TENSRO/Siload/hardware/silo_unit/README.md

# SILOAD LOAD CELL REV A — Silo Unit Carrier PCB (`68 × 44 mm`)

Silo Unit 3D Hero

Silo Unit Top View

Both Siload PCBs — Farm Hub & Silo Unit

Routing Plot

Zie [`ONTWERP.md`](ONTWERP.md) en [`../PINOUT.md`](../PINOUT.md) voor het volledige aansluitschema, de waarheidstabel van de `CD4052BE` multiplexer (`U1`) en de BOM (`BOM.csv`).

## Productie-Gerbers (JLCPCB / PCBWay / Eurocircuits)
- **Kant-en-klare ZIP voor upload:** [`SILOAD-SILO-UNIT-REV-A-gerbers.zip`](SILOAD-SILO-UNIT-REV-A-gerbers.zip)
- **Losse Gerber- en Excellon-boorbestanden:** [`gerbers/`](gerbers/) (`F.Cu`, `B.Cu`, `F.Mask`, `B.Mask`, `F.SilkS`, `B.SilkS`, `F.Paste`, `B.Paste`, `Edge.Cuts`, `PTH.drl`, `NPTH.drl`)
