TENSRO/Siload/hardware/farm_hub/README.md

# SILOAD REV A — Farm Hub Carrier PCB (`59 × 36 mm`)

Farm Hub 3D Hero

Farm Hub Top View

Both Siload PCBs — Farm Hub & Silo Unit

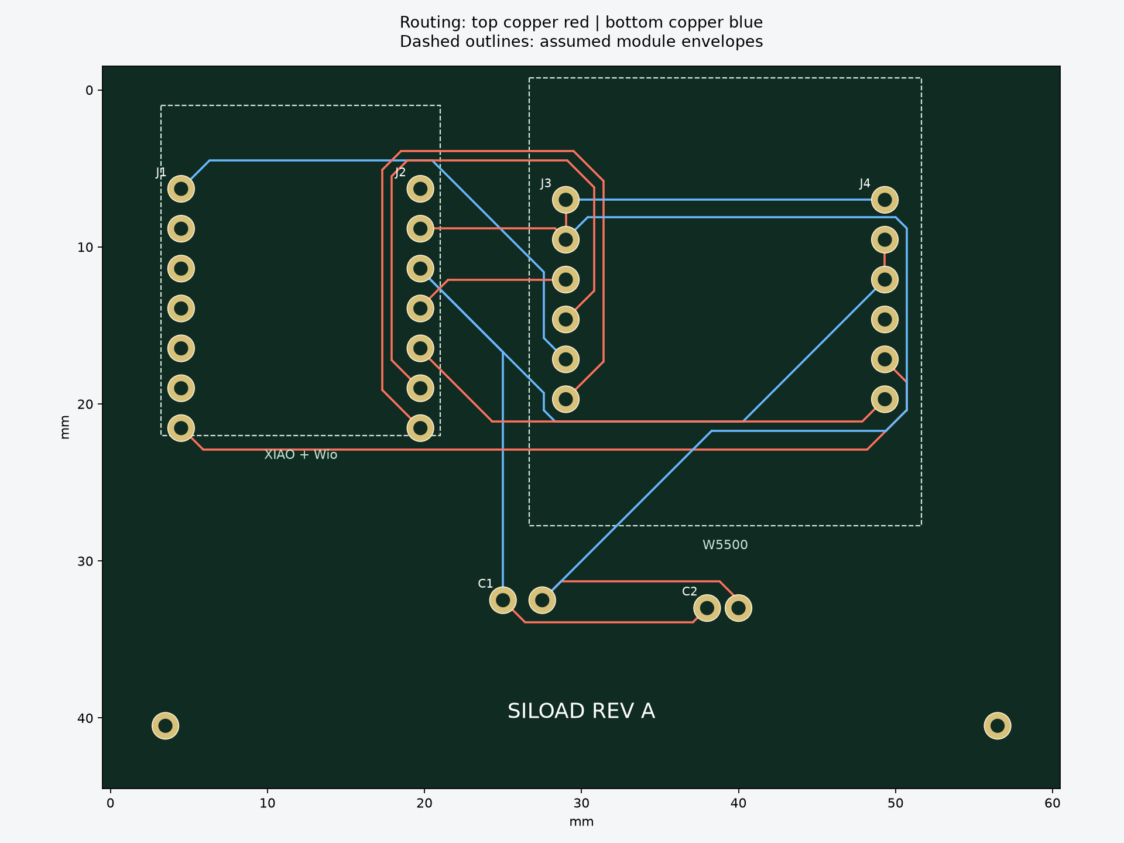
[picture p7: hardware/farm_hub/SILOAD REV A-routing.png]
Routing Plot


Zie [`ONTWERP.md`](ONTWERP.md) en [`../PINOUT.md`](../PINOUT.md) voor het volledige aansluitschema en de BOM (`BOM.csv`).
