TENSRO/Siload/hardware/farm_hub/SILOAD REV A-compact-render.png

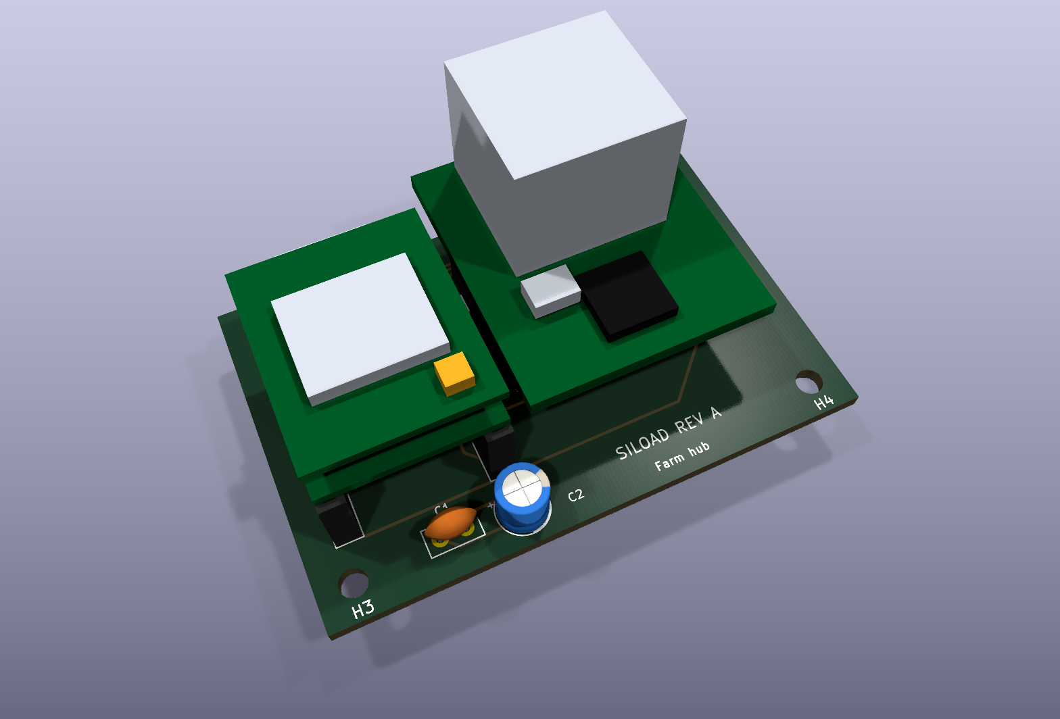
hardware/farm_hub/SILOAD REV A-compact-render.png
