TENSRO/Siload/hardware/farm_hub/SILOAD REV A-compact-top.png

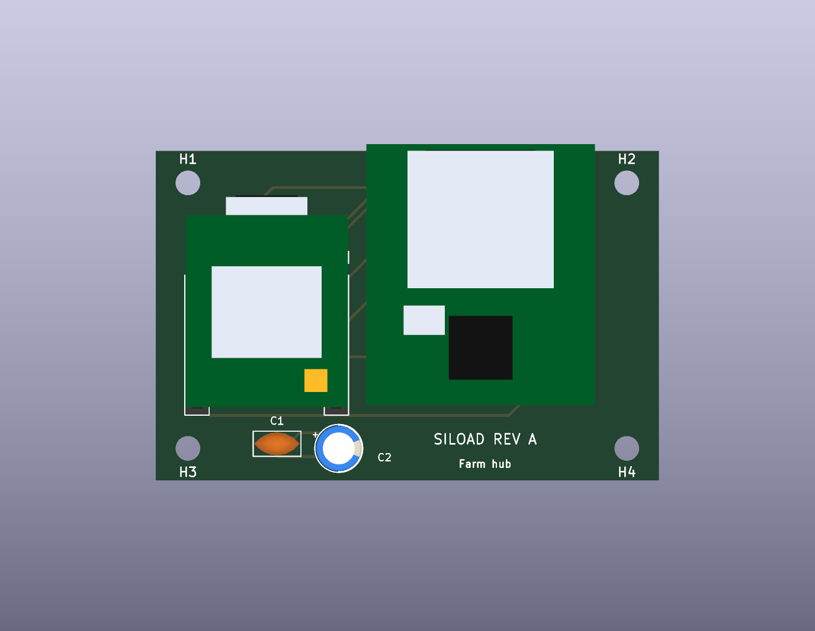
hardware/farm_hub/SILOAD REV A-compact-top.png
