TENSRO/Siload/hardware/farm_hub/visuals/SILOAD REV A-01-hero.png

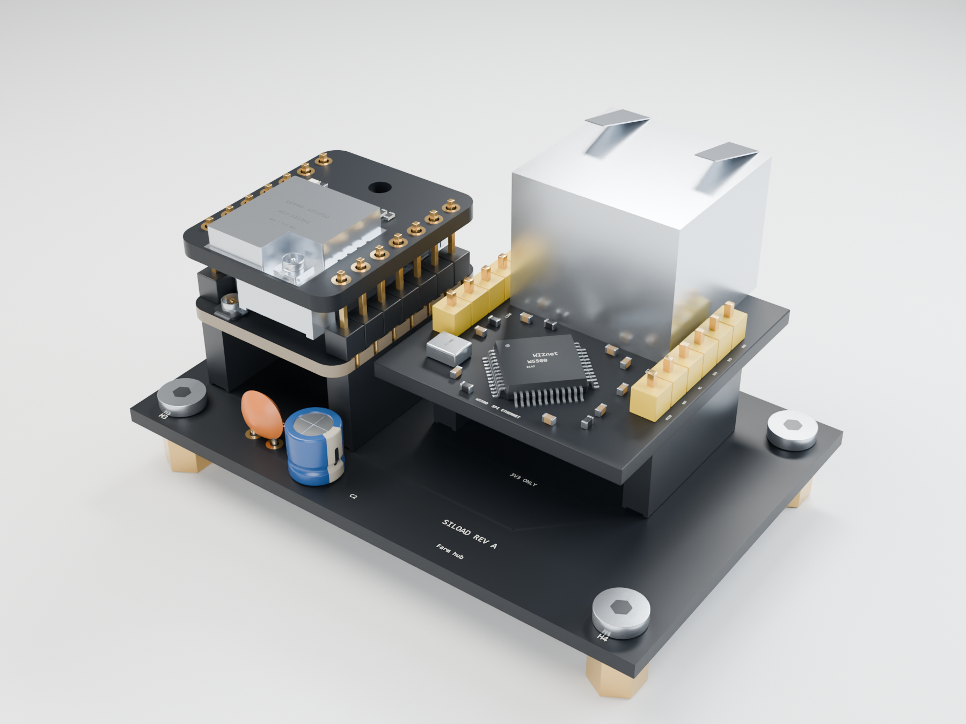
hardware/farm_hub/visuals/SILOAD REV A-01-hero.png
