TENSRO/Siload/hardware/farm_hub/visuals/SILOAD REV A-02-connectors.png

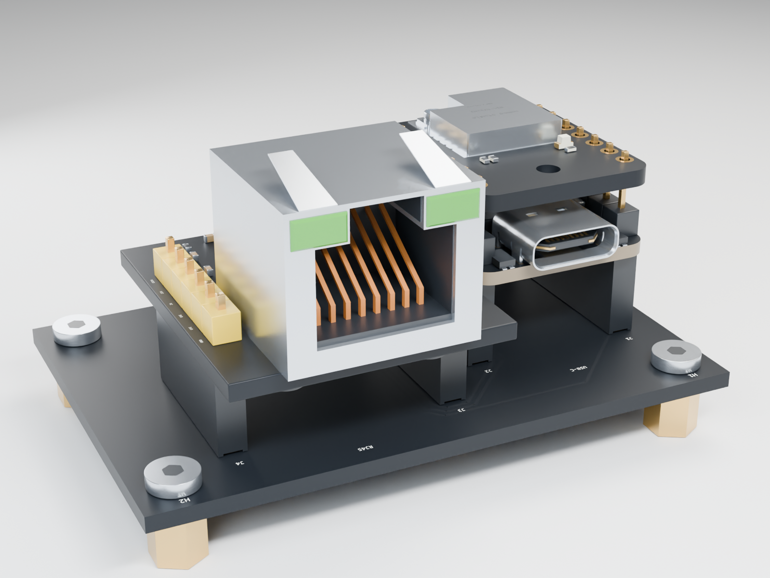
hardware/farm_hub/visuals/SILOAD REV A-02-connectors.png
