TENSRO/Siload/hardware/farm_hub/visuals/SILOAD REV A-03-detail.png

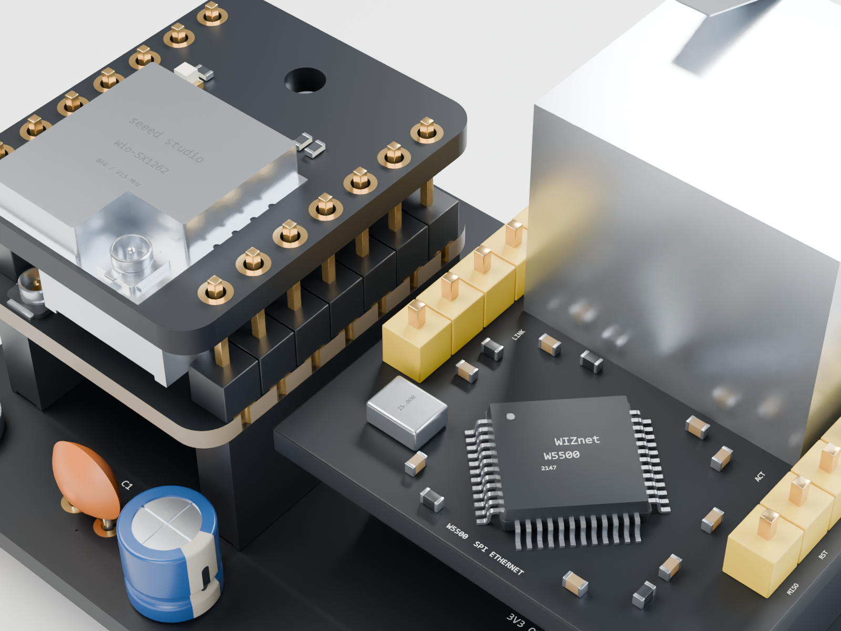
hardware/farm_hub/visuals/SILOAD REV A-03-detail.png
