TENSRO/Siload/hardware/silo_unit/branding/SiLoad-original.png

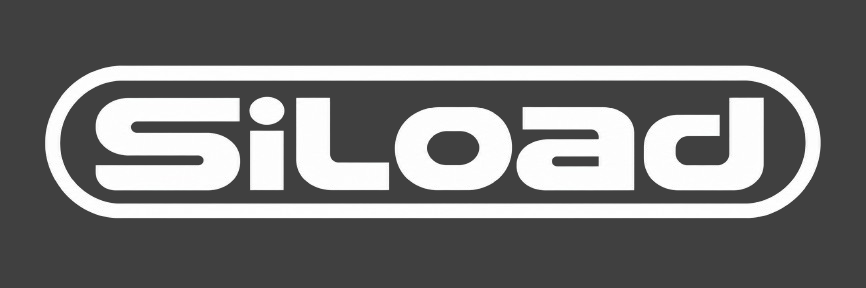
hardware/silo_unit/branding/SiLoad-original.png
