TENSRO/Siload/hardware/silo_unit/SILOAD LOAD CELL REV A-top.png

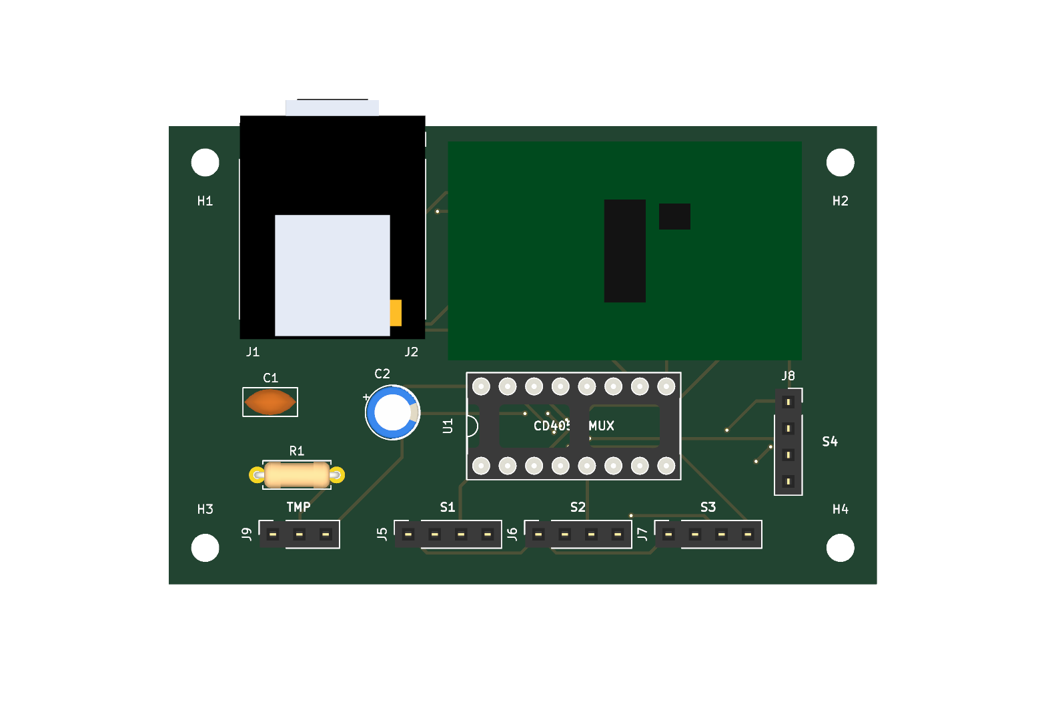
hardware/silo_unit/SILOAD LOAD CELL REV A-top.png
