TENSRO/Siload/hardware/silo_unit/visuals/SILOAD LOAD CELL REV A-03-detail.png

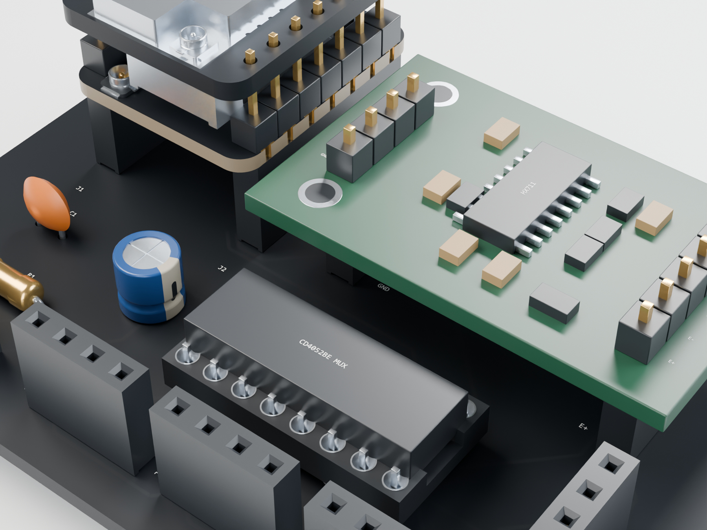
hardware/silo_unit/visuals/SILOAD LOAD CELL REV A-03-detail.png
