TENSRO/Siload/hardware/silo_unit/BOM.csv

Reference | Quantity | Description | Footprint
J1,J2 | 2 | Female header 1x7 2.54mm for XIAO ESP32-S3 + Wio-SX1262 stack | PinSocket_1x07_P2.54mm_Vertical
J3 | 1 | Female header 1x4 2.54mm for Heemol HX711 MCU side (VCC, SCK, DT, GND) | PinSocket_1x04_P2.54mm_Vertical
J4 | 1 | Female header 1x6 2.54mm for Heemol HX711 Bridge side (B+, B-, A+, A-, E-, E+) | PinSocket_1x06_P2.54mm_Vertical
U1 | 1 | CD4052BE or 74HC4052N dual 4-channel analog multiplexer (DIP-16) + 16-pin DIP socket | DIP-16_W7.62mm_Socket
J5..J8 | 4 | 4-pin 2.54mm header/socket for 4 load-cell sensors (E+, E-, A-, A+) | PinSocket_1x04_P2.54mm_Vertical
J9 | 1 | 3-pin 2.54mm header/socket for DS18B20 temperature sensor (3V3, DQ, GND) | PinSocket_1x03_P2.54mm_Vertical
J10 | 1 | 2-pin 2.54mm power header/socket (+5V, GND) for external 5V supply | PinSocket_1x02_P2.54mm_Vertical
R1 | 1 | 4.7k Ohm axial through-hole resistor (1-Wire pull-up to 3V3) | R_Axial_DIN0207_L6.3mm_D2.5mm_P7.62mm_Horizontal
C1 | 1 | 100nF 50V ceramic through-hole decoupling capacitor | C_Disc_D5.0mm_W2.5mm_P2.50mm
C2 | 1 | 10uF 16V radial electrolytic bulk decoupling capacitor on 3V3 | CP_Radial_D5.0mm_P2.00mm
H1..H4 | 4 | M2.5 mounting holes (2.7mm drill, screw head <=5mm) | MountingHole_2.7mm_M2.5
