TENSRO/Siload/hardware/farm_hub/SILOAD REV A-assembly.step

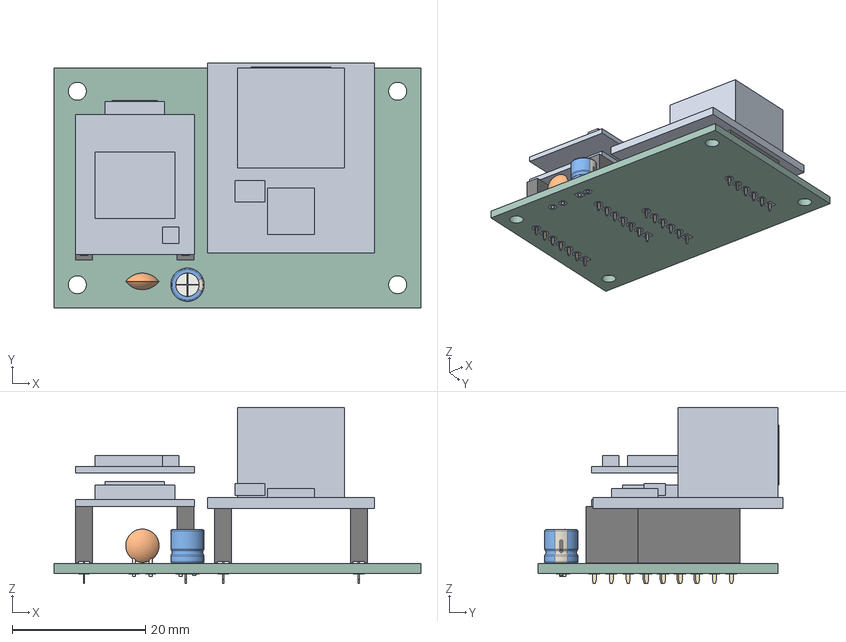
[picture p16: CAD file, 2026-10-27]
hardware/farm_hub/SILOAD REV A-assembly.step
55.0 x 36.8 x 26.4 mm
C_Disc_D50mm_W25mm_P250mm
PinSocket_1x07_P2.54mm_Vertical x 2
PinSocket_1x06_P2.54mm_Vertical x 2
CP_Radial_D50mm_P200mm
SILOAD REV A_pad
SILOAD REV A_PCB
