TENSRO/Siload/hardware/silo_unit/SILOAD LOAD CELL REV A-assembly.step

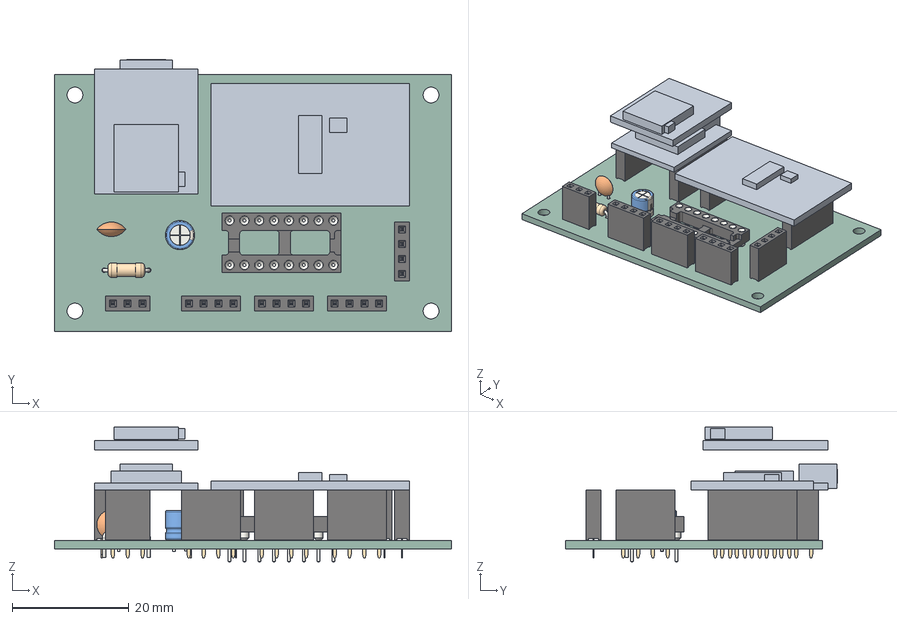
[picture p17: CAD file, 2026-10-27]
hardware/silo_unit/SILOAD LOAD CELL REV A-assembly.step
68.0 x 46.6 x 23.1 mm
CP_Radial_D50mm_P200mm
DIP_16_W762mm_Socket
PinSocket_1x03_P2.54mm_Vertical
PinSocket_1x04_P2.54mm_Vertical x 5
C_Disc_D50mm_W25mm_P250mm
PinSocket_1x07_P2.54mm_Vertical x 2
R_Axial_DIN0207_L63mm_D25mm_P762mm_Horizontal
PinSocket_1x06_P2.54mm_Vertical
SILOAD LOAD CELL REV A_PCB
