TENSRO/Siload/hardware/farm_hub/models/w5500-indicative.step

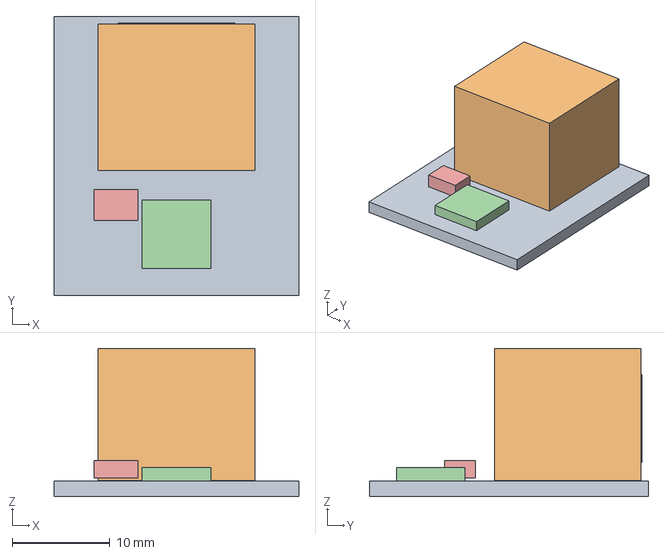
[picture p18: CAD file, 2026-10-27]
hardware/farm_hub/models/w5500-indicative.step
25.0 x 28.5 x 15.2 mm
