TENSRO/Siload/hardware/silo_unit/models/hx711-indicative.step

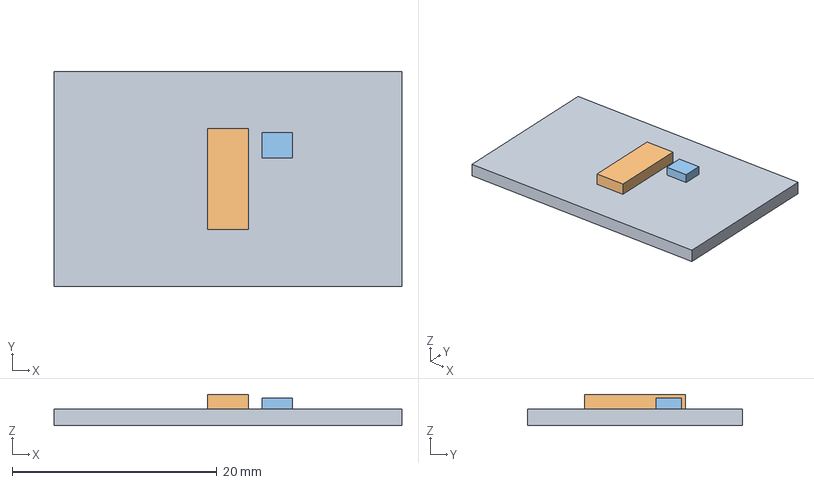
[picture p19: CAD file, 2026-10-27]
hardware/silo_unit/models/hx711-indicative.step
34.0 x 21.0 x 3.05 mm
