TENSRO/Siload/hardware/farm_hub/models/xiao-wio-indicative.step

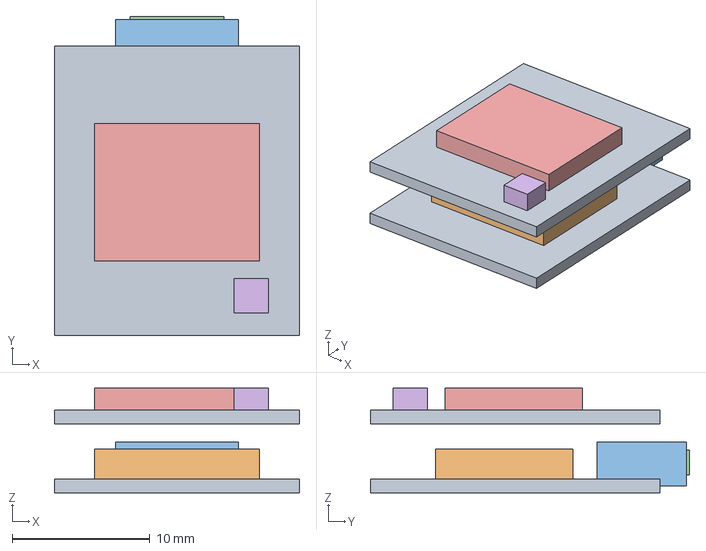
[picture p20: CAD file, 2026-10-27]
hardware/farm_hub/models/xiao-wio-indicative.step
17.8 x 23.1 x 7.60 mm
