TENSRO/Siload/hardware/farm_hub/SILOAD REV A-carrier.step

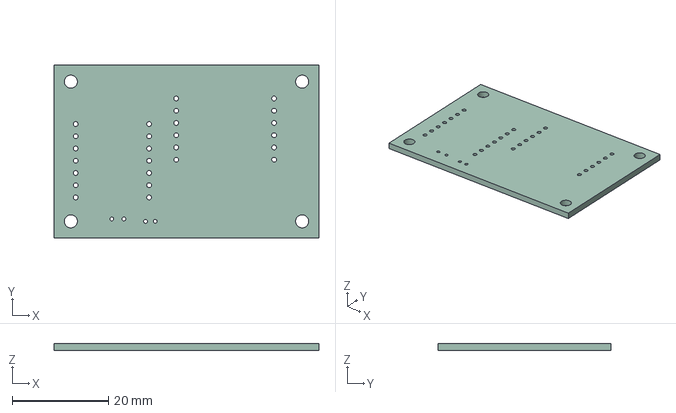
[picture p21: CAD file, 2026-10-27]
hardware/farm_hub/SILOAD REV A-carrier.step
55.0 x 36.0 x 1.51 mm
