TENSRO/Siload/(list of files, cad)

Other CAD files:
hardware/silo_unit/visuals/SILOAD LOAD CELL REV A-studio-branded.blend
