TENSRO/Siload/hardware/farm_hub/SILOAD REV A-schema.pdf

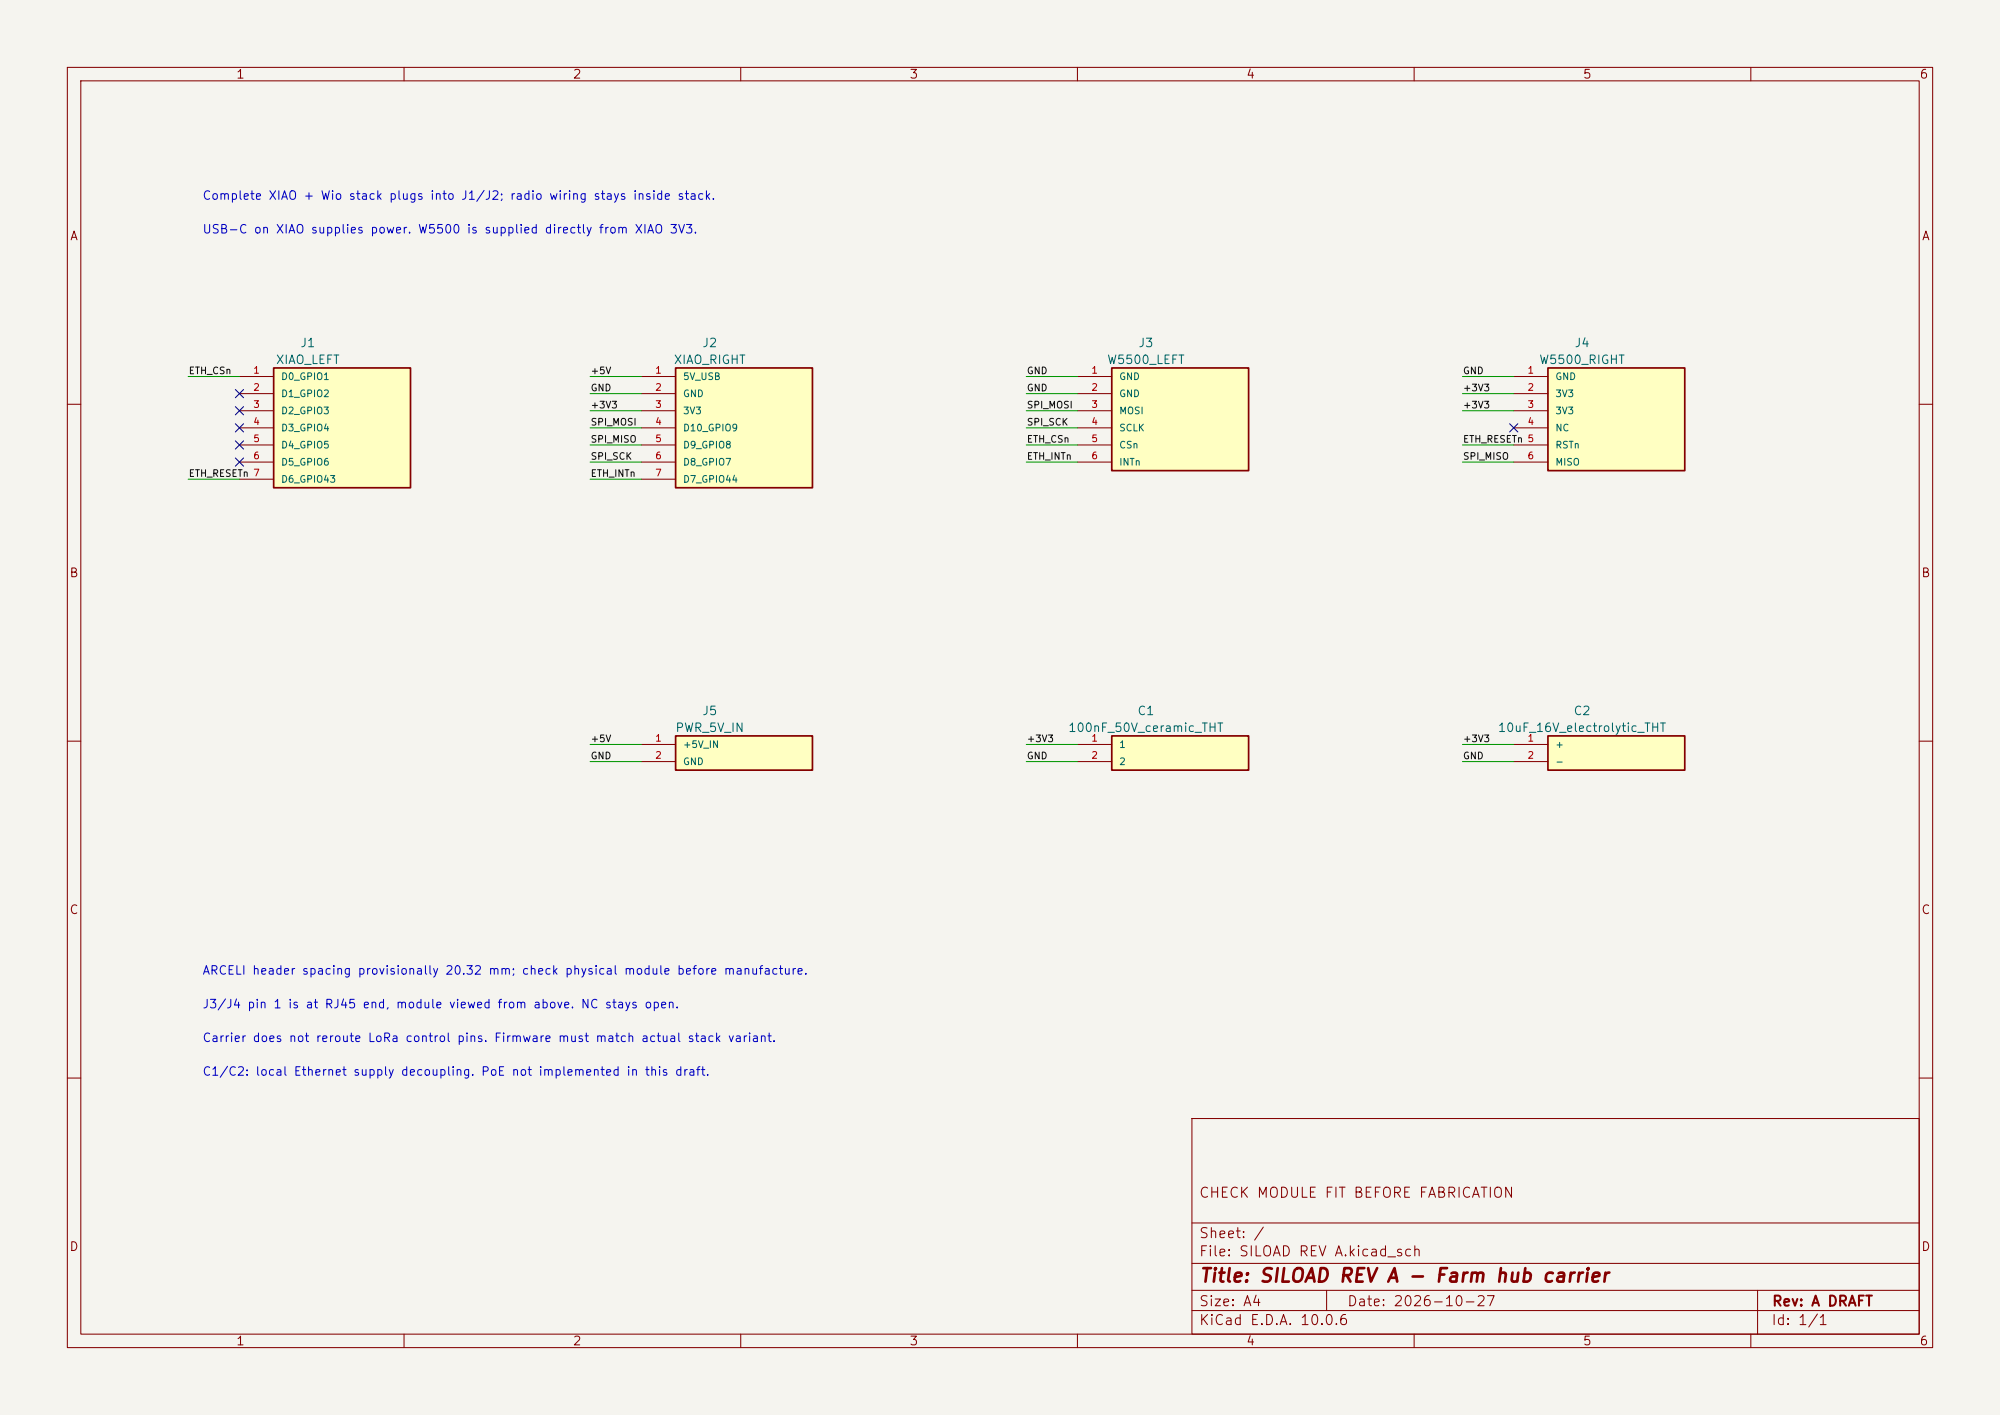
[picture p22: page 1]

USB-C on XIAO supplies power. W5500 is supplied directly from XIAO 3V3. Complete XIAO + Wio stack plugs into J1/J2; radio wiring stays inside stack. C1/C2: local Ethernet supply decoupling. PoE not implemented in this draft. J3/J4 pin 1 is at RJ45 end, module viewed from above. NC stays open. ARCELI header spacing provisionally 20.32 mm; check physical module before manufacture.

GND Carrier does not reroute LoRa control pins. Firmware must match actual stack variant.

CHECK MODULE FIT BEFORE FABRICATION

Sheet: /
File: SILOAD REV A.kicad_sch
Title: SILOAD REV A - Farm hub carrier

Size: A4 | Rev: A DRAFT
KiCad E.D.A. 10.0.6 | Id: 1/1
