TENSRO/Siload/hardware/silo_unit/SILOAD LOAD CELL REV A-schema.pdf

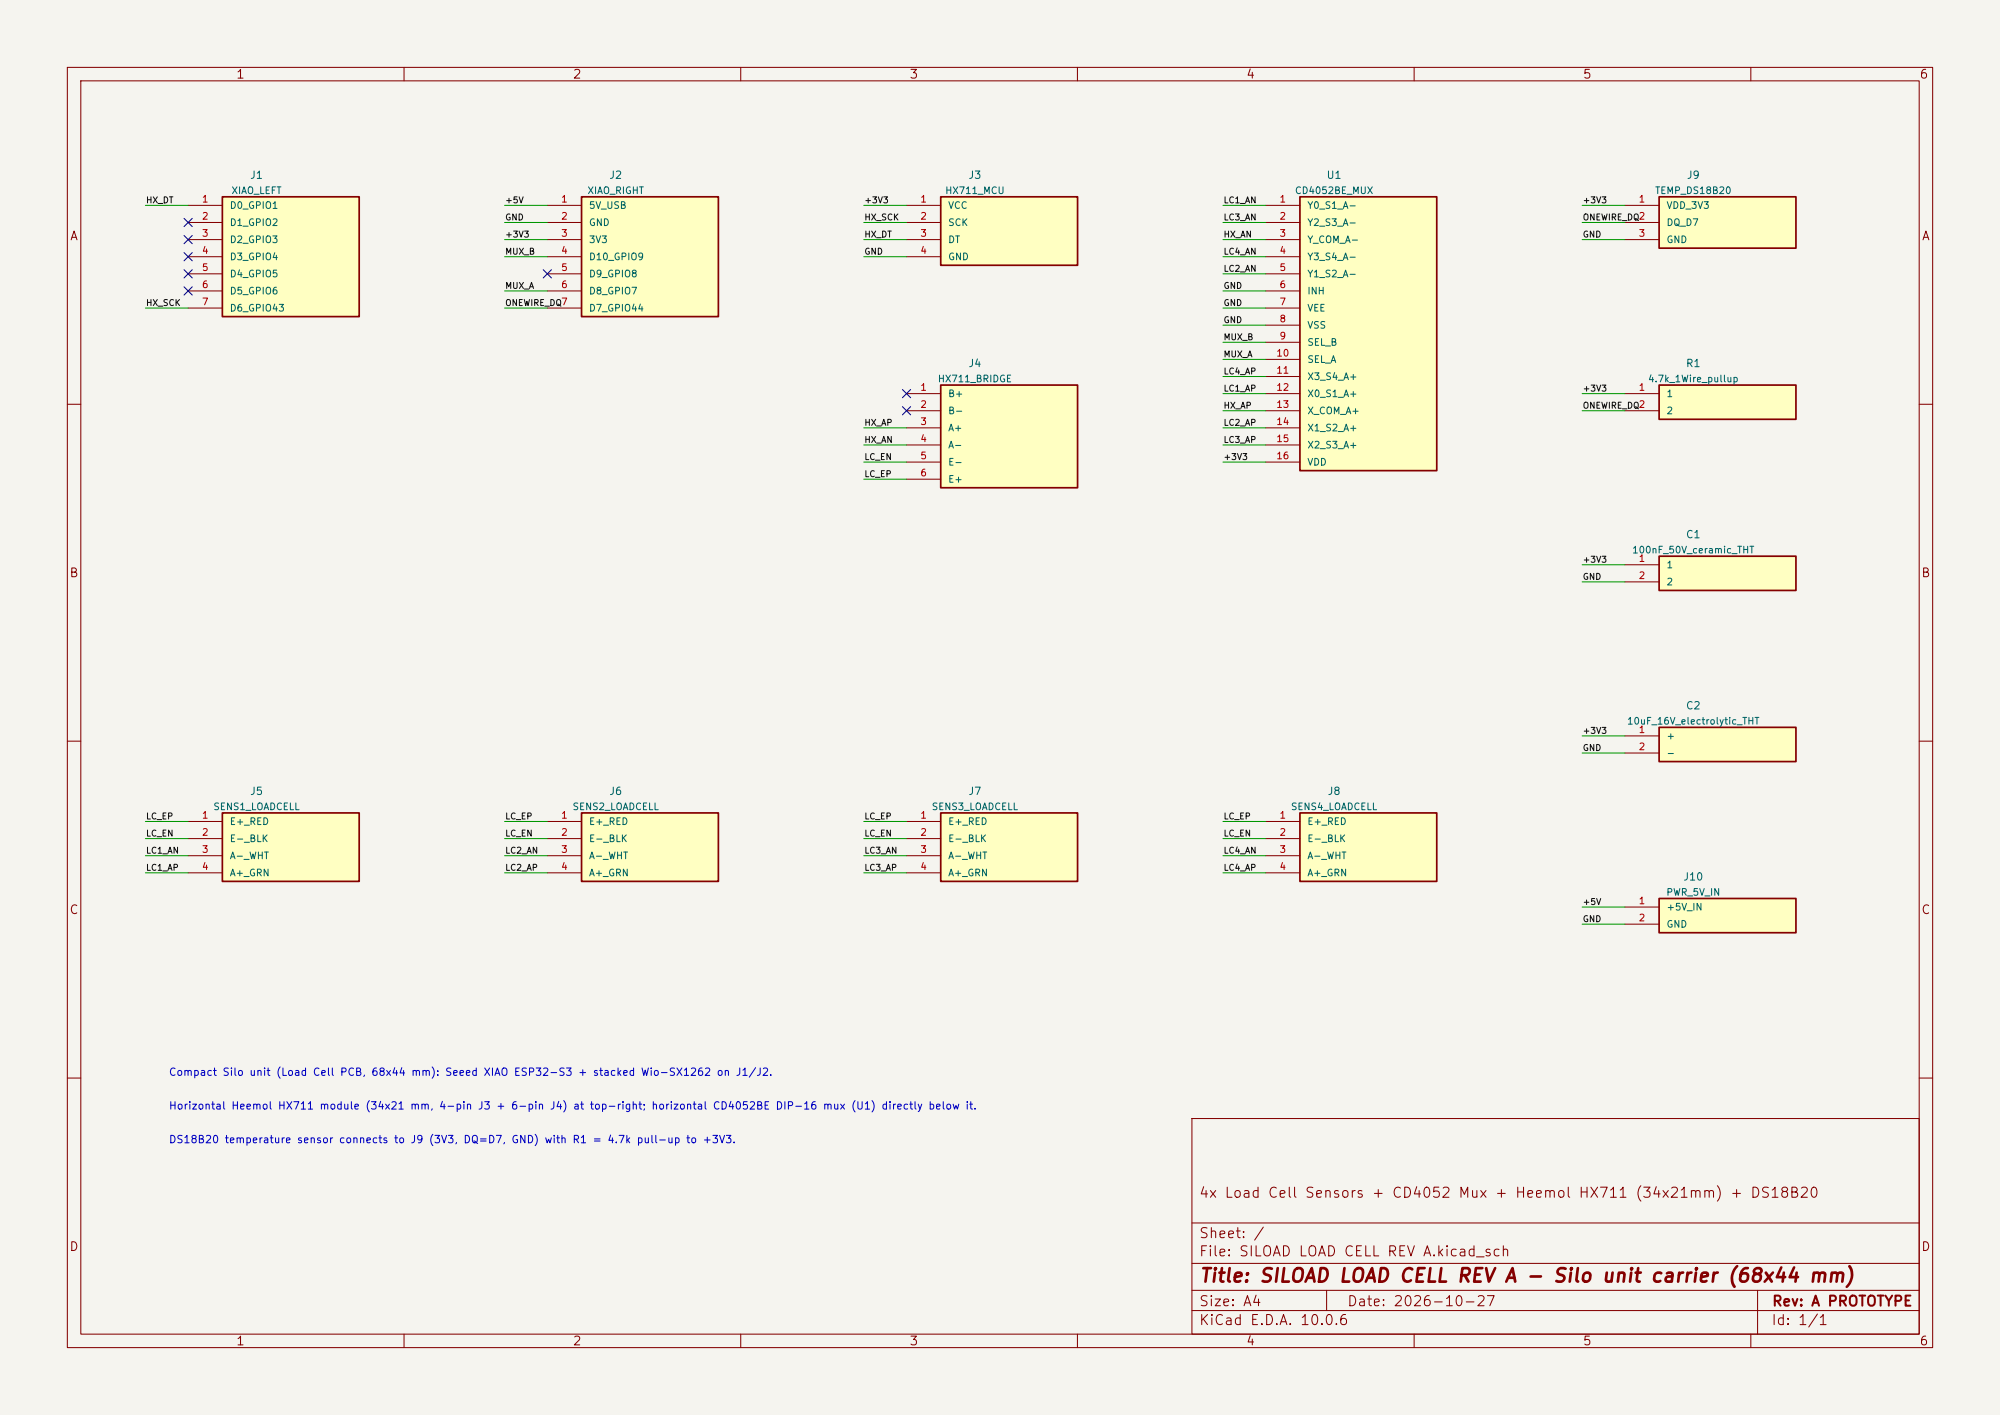
[picture p23: page 1]

DS18B20 temperature sensor connects to J9 (3V3, DQ=D7, GND) with R1 = 4.7k pull-up to +3V3. Horizontal Heemol HX711 module (34x21 mm, 4-pin J3 + 6-pin J4) at top-right; horizontal CD4052BE DIP-16 mux (U1) directly below it. Compact Silo unit (Load Cell PCB, 68x44 mm): Seeed XIAO ESP32-S3 + stacked Wio-SX1262 on J1/J2.

4x Load Cell Sensors + CD4052 Mux + Heemol HX711 (34x21mm) + DS18B20

Sheet: /
File: SILOAD LOAD CELL REV A.kicad_sch
Title: SILOAD LOAD CELL REV A - Silo unit carrier (68x44 mm)

Size: A4 | Rev: A PROTOTYPE
KiCad E.D.A. 10.0.6 | Id: 1/1
