TENSRO/Siload/hardware/silo_unit/SILOAD LOAD CELL REV A.kicad_pcb

## KiCad design hardware/silo_unit/SILOAD LOAD CELL REV A.kicad_pcb (2026-10-27)

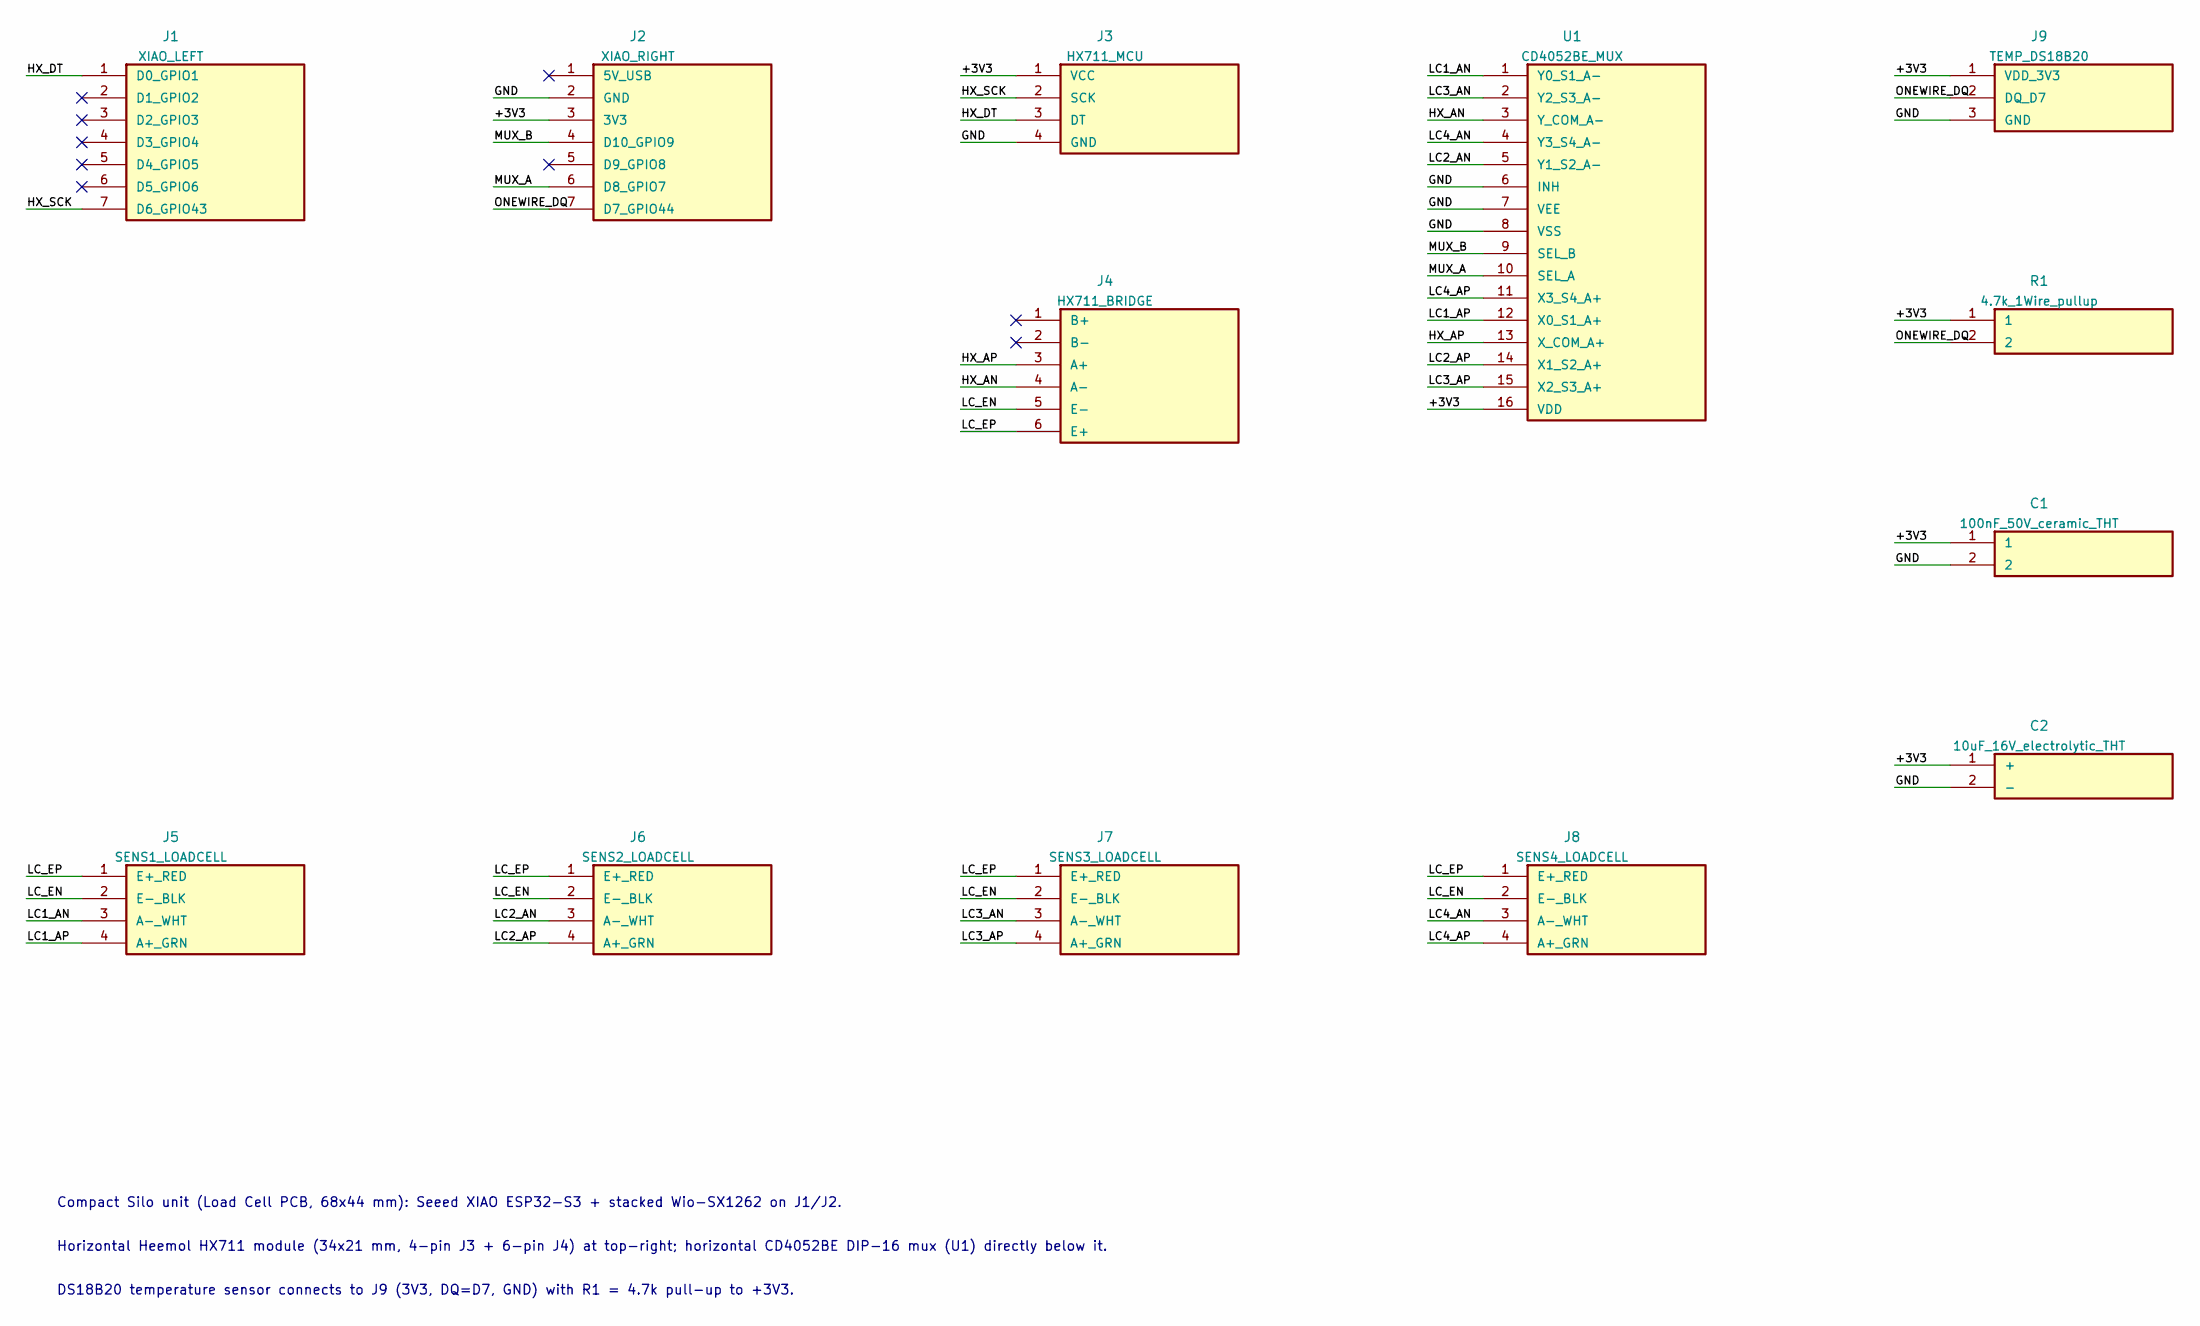
[picture p24: schematic SILOAD LOAD CELL REV A.kicad_sch, SILOAD LOAD CELL REV A - Silo unit carrier (68x44 mm)]

Parts:
C1: 100nF_50V_ceramic_THT; C_Disc_D5.0mm_W2.5mm_P2.50mm
C2: 10uF_16V_electrolytic_THT; CP_Radial_D5.0mm_P2.00mm
J1: XIAO_LEFT; PinSocket_1x07_P2.54mm_Vertical
J2: XIAO_RIGHT; PinSocket_1x07_P2.54mm_Vertical
J3: HX711_MCU; PinSocket_1x04_P2.54mm_Vertical
J4: HX711_BRIDGE; PinSocket_1x06_P2.54mm_Vertical
J5: SENS1_LOADCELL; PinSocket_1x04_P2.54mm_Vertical
J6: SENS2_LOADCELL; PinSocket_1x04_P2.54mm_Vertical
J7: SENS3_LOADCELL; PinSocket_1x04_P2.54mm_Vertical
J8: SENS4_LOADCELL; PinSocket_1x04_P2.54mm_Vertical
J9: TEMP_DS18B20; PinSocket_1x03_P2.54mm_Vertical
R1: 4.7k_1Wire_pullup; R_Axial_DIN0207_L6.3mm_D2.5mm_P7.62mm_Horizontal
U1: CD4052BE_MUX; DIP-16_W7.62mm_Socket

Connections:
/+3V3: C1.1, C2.1 (+), J2.3 (3V3), J3.1 (VCC), J9.1 (VDD_3V3), R1.1, U1.16 (VDD)
/GND: C1.2, C2.2 (-), J2.2 (GND), J3.4 (GND), J9.3 (GND), U1.6 (INH), U1.7 (VEE), U1.8 (VSS)
/HX_AN: J4.4 (A-), U1.3 (Y_COM_A-)
/HX_AP: J4.3 (A+), U1.13 (X_COM_A+)
/HX_DT: J1.1 (D0_GPIO1), J3.3 (DT)
/HX_SCK: J1.7 (D6_GPIO43), J3.2 (SCK)
/LC1_AN: J5.3 (A-_WHT), U1.1 (Y0_S1_A-)
/LC1_AP: J5.4 (A+_GRN), U1.12 (X0_S1_A+)
/LC2_AN: J6.3 (A-_WHT), U1.5 (Y1_S2_A-)
/LC2_AP: J6.4 (A+_GRN), U1.14 (X1_S2_A+)
/LC3_AN: J7.3 (A-_WHT), U1.2 (Y2_S3_A-)
/LC3_AP: J7.4 (A+_GRN), U1.15 (X2_S3_A+)
/LC4_AN: J8.3 (A-_WHT), U1.4 (Y3_S4_A-)
/LC4_AP: J8.4 (A+_GRN), U1.11 (X3_S4_A+)
/LC_EN: J4.5 (E-), J5.2 (E-_BLK), J6.2 (E-_BLK), J7.2 (E-_BLK), J8.2 (E-_BLK)
/LC_EP: J4.6 (E+), J5.1 (E+_RED), J6.1 (E+_RED), J7.1 (E+_RED), J8.1 (E+_RED)
/MUX_A: J2.6 (D8_GPIO7), U1.10 (SEL_A)
/MUX_B: J2.4 (D10_GPIO9), U1.9 (SEL_B)
/ONEWIRE_DQ: J2.7 (D7_GPIO44), J9.2 (DQ_D7), R1.2

Notes on the sheet:
Compact Silo unit (Load Cell PCB, 68x44 mm): Seeed XIAO ESP32-S3 + stacked Wio-SX1262 on J1/J2.
Horizontal Heemol HX711 module (34x21 mm, 4-pin J3 + 6-pin J4) at top-right; horizontal CD4052BE DIP-16 mux (U1) directly below it.
DS18B20 temperature sensor connects to J9 (3V3, DQ=D7, GND) with R1 = 4.7k pull-up to +3V3.

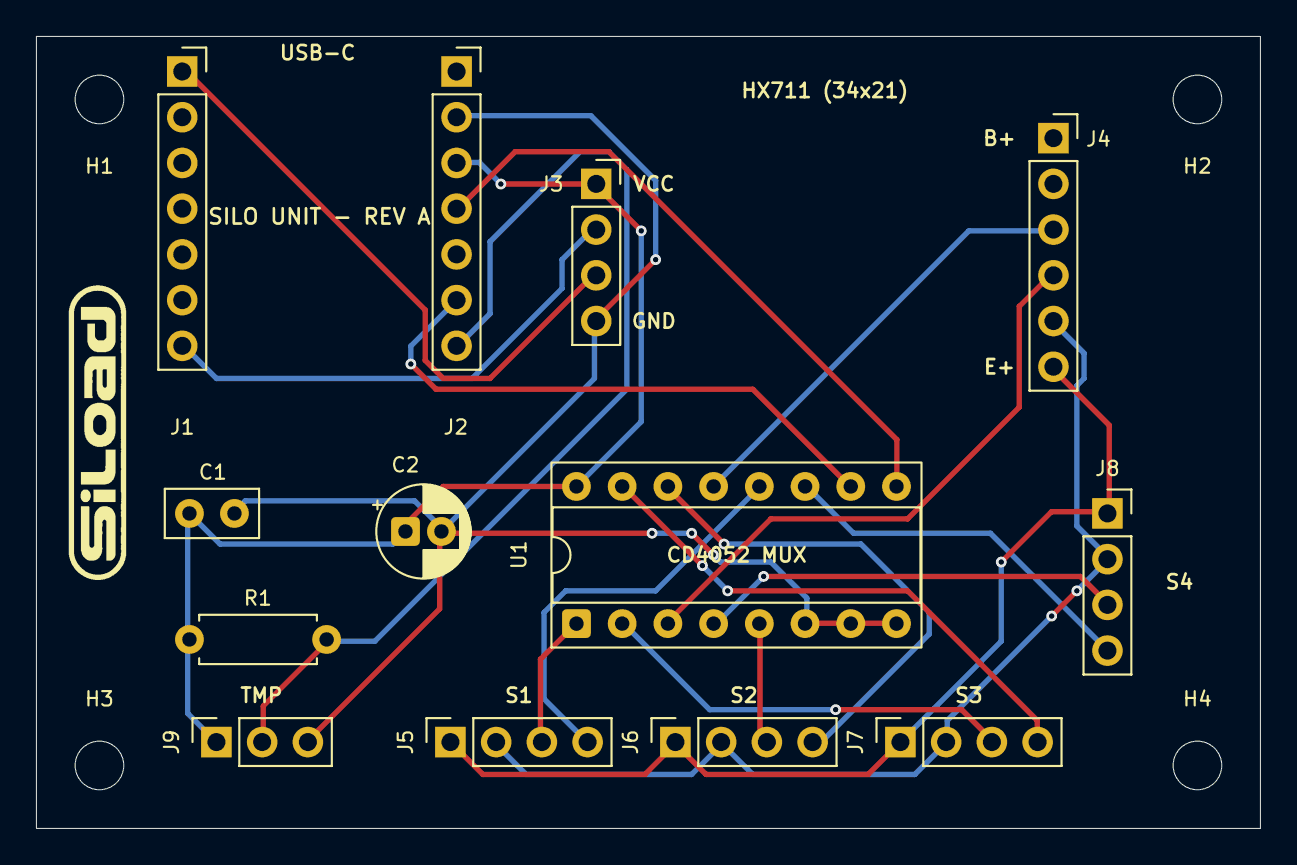
[picture p25: board SILOAD LOAD CELL REV A.kicad_pcb from above]

Board: 2 copper layers, 68.0 x 44.0 mm, 18 parts (0 on the bottom side), 19 nets.

Other parts of the board:
H1, H2, H3, H4: M2.5; MountingHole_2.7mm_M2.5
LOGO1: SiLoad badge vertical
