TENSRO/Siload/hardware/farm_hub/SILOAD REV A.kicad_pcb

## KiCad design hardware/farm_hub/SILOAD REV A.kicad_pcb (2026-10-27)

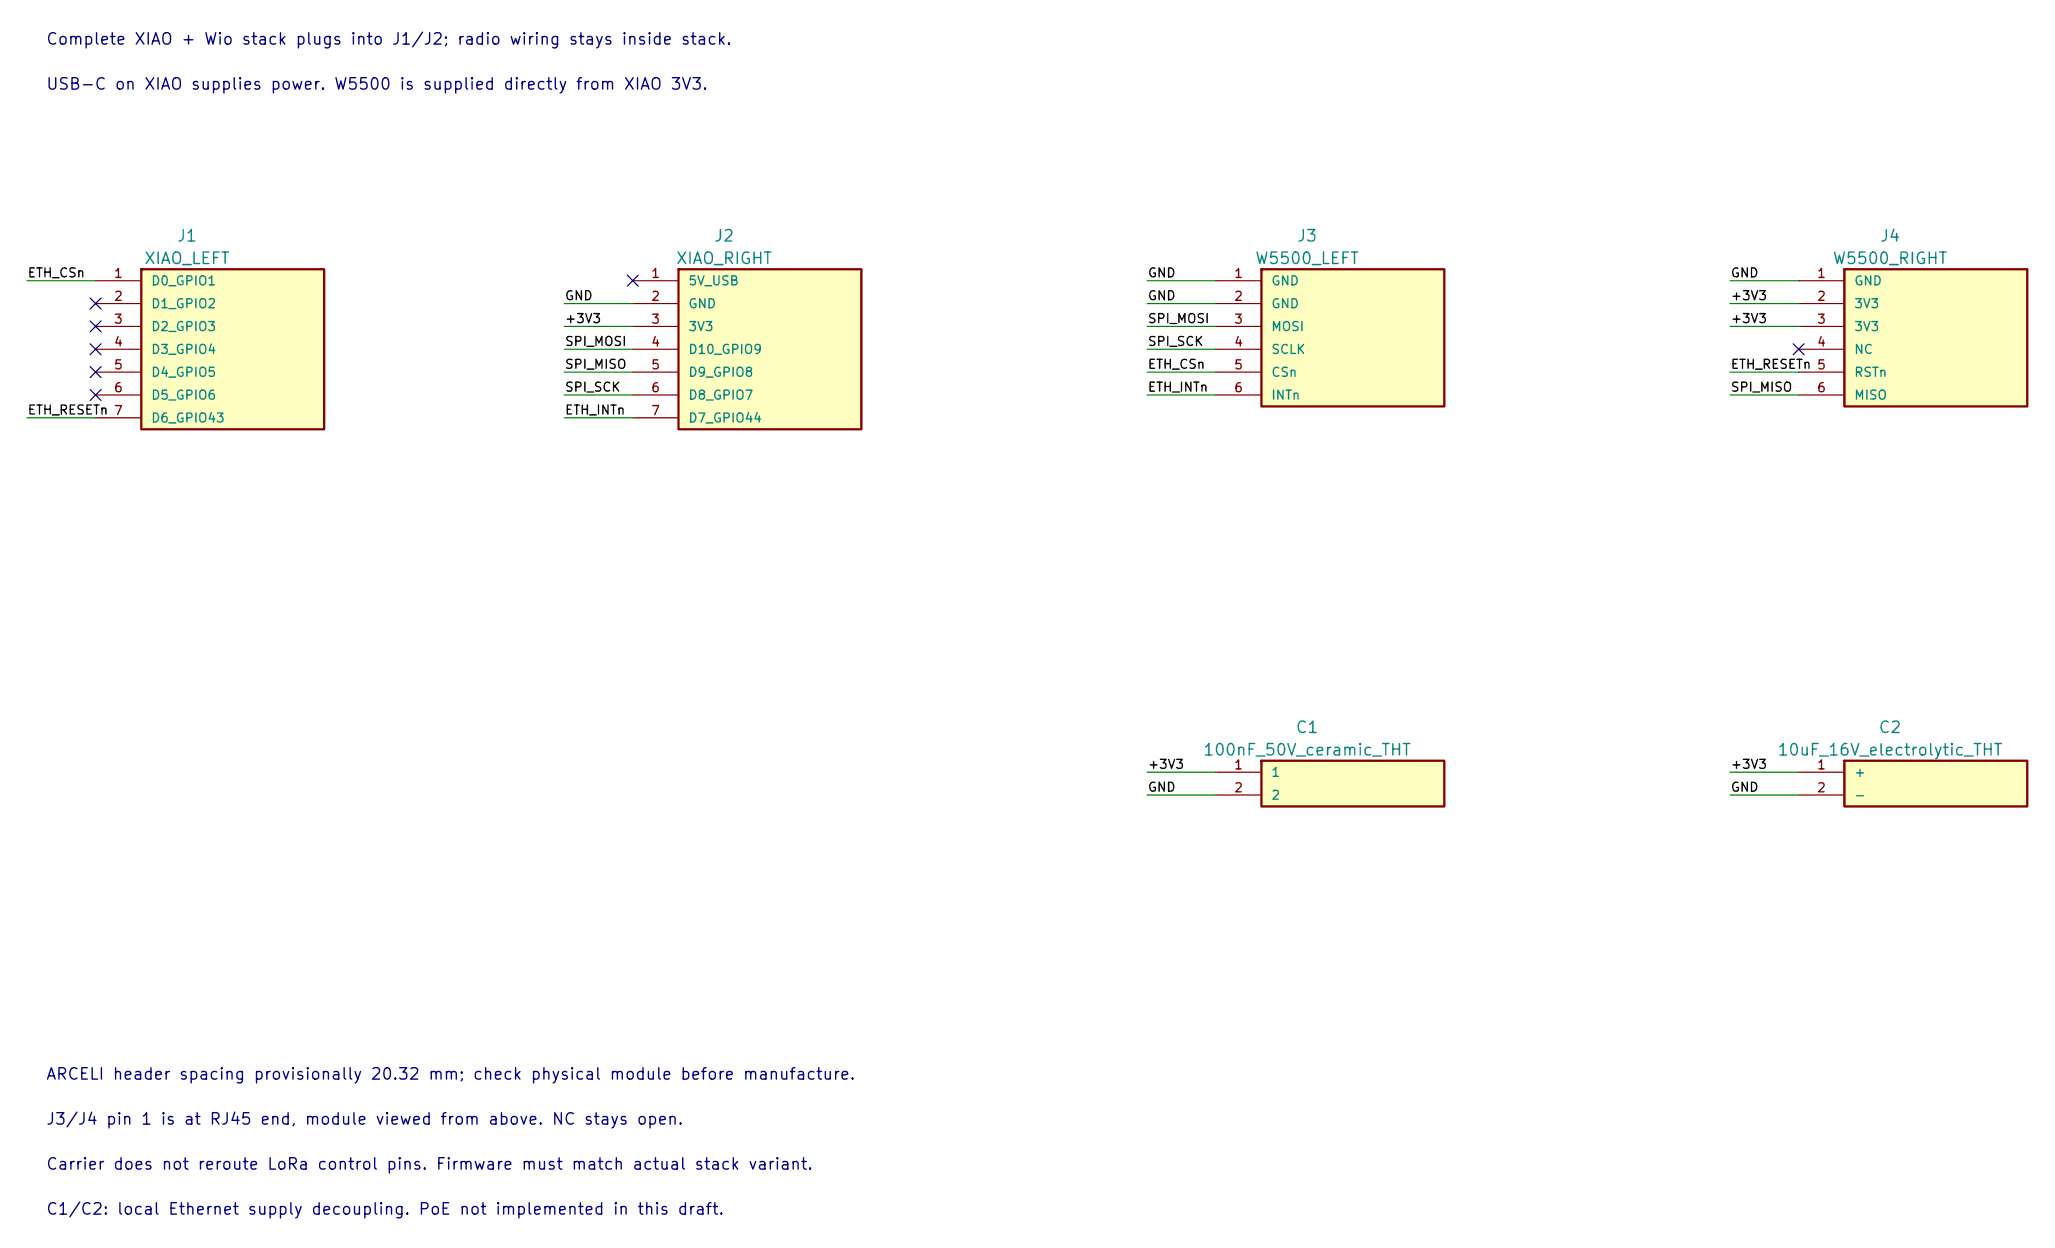
[picture p26: schematic SILOAD REV A.kicad_sch, SILOAD REV A - Farm hub carrier]

Parts:
C1: 100nF_50V_ceramic_THT; C_Disc_D5.0mm_W2.5mm_P2.50mm
C2: 10uF_16V_electrolytic_THT; CP_Radial_D5.0mm_P2.00mm
J1: XIAO_LEFT; PinSocket_1x07_P2.54mm_Vertical
J2: XIAO_RIGHT; PinSocket_1x07_P2.54mm_Vertical
J3: W5500_LEFT; PinSocket_1x06_P2.54mm_Vertical
J4: W5500_RIGHT; PinSocket_1x06_P2.54mm_Vertical

Connections:
/+3V3: C1.1, C2.1 (+), J2.3 (3V3), J4.2 (3V3), J4.3 (3V3)
/ETH_CSn: J1.1 (D0_GPIO1), J3.5 (CSn)
/ETH_INTn: J2.7 (D7_GPIO44), J3.6 (INTn)
/ETH_RESETn: J1.7 (D6_GPIO43), J4.5 (RSTn)
/GND: C1.2, C2.2 (-), J2.2 (GND), J3.1 (GND), J3.2 (GND), J4.1 (GND)
/SPI_MISO: J2.5 (D9_GPIO8), J4.6 (MISO)
/SPI_MOSI: J2.4 (D10_GPIO9), J3.3 (MOSI)
/SPI_SCK: J2.6 (D8_GPIO7), J3.4 (SCLK)

Notes on the sheet:
Complete XIAO + Wio stack plugs into J1/J2; radio wiring stays inside stack.
USB-C on XIAO supplies power. W5500 is supplied directly from XIAO 3V3.
ARCELI header spacing provisionally 20.32 mm; check physical module before manufacture.
J3/J4 pin 1 is at RJ45 end, module viewed from above. NC stays open.
Carrier does not reroute LoRa control pins. Firmware must match actual stack variant.
C1/C2: local Ethernet supply decoupling. PoE not implemented in this draft.

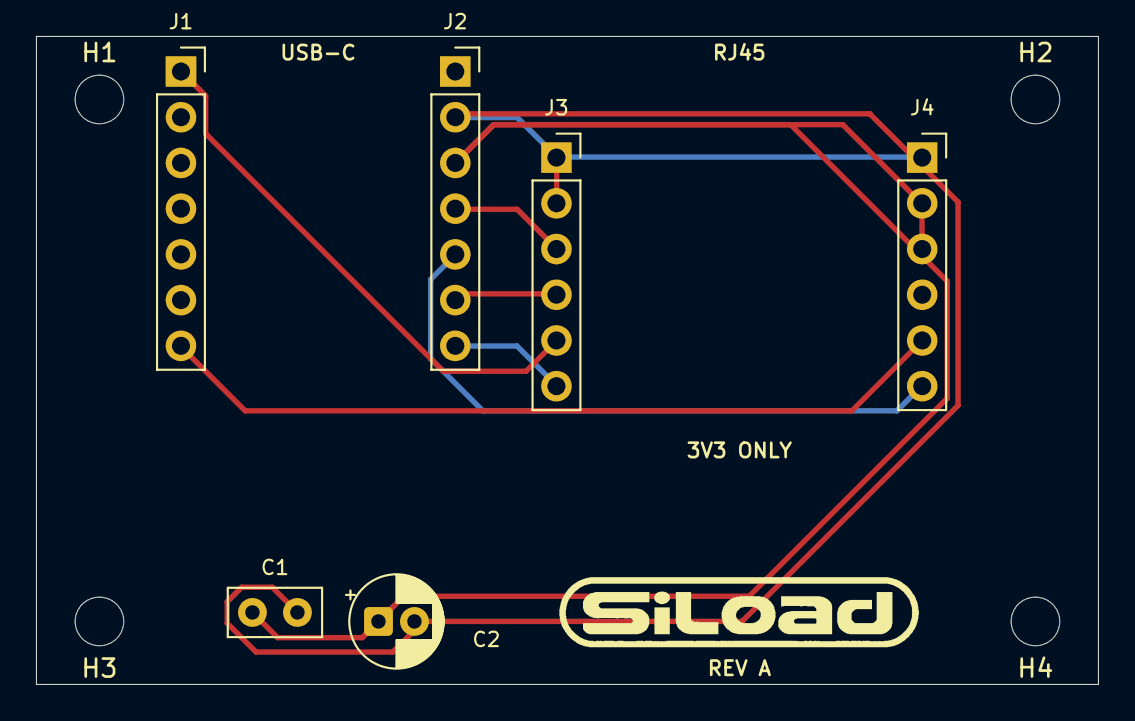
[picture p27: board SILOAD REV A.kicad_pcb from above]

Board: 2 copper layers, 59.0 x 36.0 mm, 11 parts (0 on the bottom side), 8 nets.

Other parts of the board:
H1, H2, H3, H4: M2.5; MountingHole_2.7mm_M2.5
LOGO1: SiLoad badge 20mm; SiLoad_Badge_20mm
