TENSRO/Siload/hardware/farm_hub/layout_config.py

BOARD_WIDTH=59
BOARD_HEIGHT=36
MOUNTING_HOLES=[('H1',53.5,53.5),('H2',105.5,53.5),('H3',53.5,82.5),('H4',105.5,82.5)]
SCREW_HEAD_DIAMETER=5.0
REFERENCE_POSITIONS={'H1':(53.5,50.9),'H2':(105.5,50.9),'H3':(53.5,85.1),'H4':(105.5,85.1),'C2':(75,83.5)}
XIAO_HEADERS=(58.03,51.948)
ETH_HEADERS=(78.89,56.73)
LOGO_CENTER=(89.05,82)
PORT_FRONT_Y=2.5
