TENSRO/Siload/(commit log)

2026-10-09 Add bench firmware, USB bridge and live dashboard for load cell testing (#1)
    * Add bench firmware, USB bridge and live dashboard for load cell testing
    First step of the firmware + data storage phase: read one HX711 load cell and
    a DS18B20 temperature sensor on a Seeed XIAO, store readings in SQLite and
    show them live on localhost so the sensor setup can be tested on the bench.
    - firmware/siload_bench: reads up to 4 HX711s and DS18B20s, prints one JSON
    reading per second over USB (optional Wi-Fi POST via git-ignored secrets.h)
    - firmware/flash.sh: detects ESP32-C3/S3 and flashes with arduino-cli
    - server/server.py: stdlib HTTP server + SQLite, ingest API, CSV export
    - server/serial_bridge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
2026-10-15 Add Windows support, move HX711 off the LoRa SPI pins, add LoRa test and farm hub (#2)
    - serial_bridge.py: Windows support via the Win32 API (ctypes) and a registry
    lookup for USB COM ports; still standard library only. Bluetooth COM ports
    are skipped.
    - firmware/flash.ps1 + flash.cmd: Windows version of flash.sh (auto-detects
    the port and the C3/S3 chip).
    - siload_bench: HX711 moved from D9/D10 to D0 (DT) / D6 (SCK), because the
    Wio-SX1262 uses D8/D9/D10 as its SPI bus and D1-D5 for control. Only one
    HX711 fits next to the LoRa module.
    - firmware/lora_test: step-by-step wiring check for the Wio-SX1262 for XIAO
    (RESET/BUSY, SPI, DIO1, RX noise floor), then a test packet every 5 s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
2026-10-15 Send Siload readings over LoRa to the farm hub (#3)
    - siload_bench: initialise the Wio-SX1262 and send the latest reading over
    LoRa every 15 s (EU868 1% airtime at SF7). USB output stays at 1 s.
    - farm_hub: a Siload reading is printed as the server's JSON with "rssi" and
    "snr" added, so serial_bridge.py on the hub's port feeds the dashboard.
    Other packets are printed as [lora] lines.
    - All three sketches now use the same radio settings: 868.0 MHz, 125 kHz,
    SF7, CR 4/5, sync word 0x12.
    Tested on hardware: the hub received 3/3 packets from the Siload in 35 s
    (RSSI -2 dBm, SNR 12.8 dB on the bench at 14 dBm). raw is null because no
    HX711 is connected to D0/D6 yet.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
2026-10-16 Read the DS18B20 with OneWireNg so it works on the ESP32-S3 (#5)
    On the XIAO ESP32-S3, D7 is GPIO 44. The OneWire library only allows
    pins up to 33 as outputs (true on the original ESP32, not on the S3), so
    it could never send the 1-Wire reset pulse: the bus idled HIGH with the
    pull-up in place, but no sensor was ever found. It worked on the C3
    because D7 is GPIO 20 there.
    OneWireNg checks output pins per chip and handles GPIO 32+ on the S3.
    Behaviour is unchanged: conversion runs in the background between
    readings, a lost sensor reports null, the bus is rescanned every 10 s
    and the wiring diagnosis is still printed when no sensor is found.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
2026-10-16 Draw charts and status correctly for 15 s LoRa readings (#6)
    Readings that arrive through the farm hub come every 15 s, not every
    second. The chart broke the line wherever readings were more than ~5 s
    apart (meant for gaps like an unplugged board), so every LoRa segment
    counted as a gap and the 10 min / 1 h views drew nothing. The status dot
    also turned "stale" after 10 s, so it flickered between packets.
    - Gap threshold is now 3x the median interval between readings (1 s
    over USB, 15 s over LoRa, or the bucket size for averaged views).
    - Dots are drawn whenever readings are at least 4 px apart, so sparse
    LoRa readings stay visible in any window.
    - Status is live up to 30 s since the la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
2026-10-27 Add hardware pinout for the silo unit and farm hub PCBs (#7)
    Reference for the carrier PCB design: which XIAO pin goes where on the
    silo unit (XIAO ESP32-S3 Plus, 4 x HX711, DS18B20) and the farm hub
    (XIAO ESP32-S3, W5500 Ethernet), both with the Wio-SX1262 stacked on top.
2026-10-27 Add Farm Hub carrier PCB KiCad design and 3D visuals (SILOAD REV A)
2026-10-27 Add Silo Unit PCB (68x44mm, Heemol HX711 + CD4052 4x Mux + DS18B20) and studio renders
2026-10-27 Place SiLoad logo vertically on left side of Silo Unit PCB for top-down visibility
2026-10-27 Add PCB studio render banner to top of README and hardware READMEs
2026-10-27 Add production Gerbers and ZIP archives for Farm Hub and Silo Unit PCBs
2026-10-28 Add dedicated 2-pin 5V/GND power connectors, update renders and production Gerbers
